x0pherl/fender-bender/(threads)

Thread 1 (2024-09-26):

Request for a "drybox" configuration

x0pherl, 2024-09-26:
Request on reddit announcement:

> I'd like an airtight, "drybox" version of this. It is rather humid in my house and I need a closed path to the printer.

There's already a "solid walls" option in the config, but this would also require a box around the bottom part.

x0pherl, 2024-11-11:
The external walls and bottom bracket now all feature a drybox configuration generated to the "alt" directory. This will be included in release 2.0

Closed 2024-11-11.

Thread 2 (2024-09-27):

Question: How doe this improve on your older design?

JohnOCFII, 2024-09-27:
I've been using your previous design successfully since 2021.  I'd love to hear how this differs.  I really like unit I'm using but have considered a change for three reasons:

1) Filament seems to break when sitting for more than a week.  This might be unavoidable due to the way the filament is positioned as it flows through the buffer.

2) Occasionally I struggle to get the filament to exit the unit as it gets caught on the M10, and I have to twist it quite a bit to get it to flow smoothly through the opening.

3) I'd like to try to better seal the box, as I've found that I get much better prints when my filament is dry, and while I'm starting from a sealed/dry RepBox, the current solution is out in the open.  I guess I can go with the sealed walls as a start.

Thanks!

x0pherl, 2024-09-27:
hey, nice to know the previous design was working for you. i'll address your issues and talk about general improvements.

1. that's a factor of the PTFE tubes, filament gets brittle in the tubes. i've seen this discussed enough to consider it "generally known" although google might reveal reasons. the "standard version" of this new design uses 3mm ID, 6mm OD tubing; I'm curious to see if this helps with that problem, but i haven't been using it long enough to know yet.
2. this design uses no connectors on the buffer, or alternative bottom brackets use "pass through connectors". In either of these cases, the path of the filament through the connector (and even through the part) is lined, which eliminates the catching you describe (and also greatly reduces overall friction. this was a design goal for this project
3. There's already an [issue ](https://github.com/x0pherl/fender-bender/issues/1) opened for a sealed version; this will mostly require some redesign of the bottom part but it should be pretty easy, but it will be a while before I get to it. But thanks for weighing in, I definitely am interested in what folks are looking for, and this seems to be a common request.

Other improvements:
- the path of the filament now exits the buffer at a 45 degree angle. installing such that there's a straight path to your filament and a straight path to the MMU has cut friction more that 4x from the design you're using (in fact my first model did that so effectively that it pushed the filament right around the wheel and back into my repbox)
- the "bracket" no longer has those awful printed screws, it just snaps into place. this makes me happy every time I assemble one.
- you could achieve this without printing a whole new buffer, but the PTFE stepdown adapter design makes the path from the buffer to the printer more easily user serviced. this makes loading filament way easier.
- the 6mm OD tubing is significantly more durable than 4mm tubing. it makes it a little "stiffer" when changing filament, but should mean better performance and durability over time.
- the new design is much easier to tinker with than the old one, which should allow for more variants in the future (such as a drybox config or different entry / exit angles, etc.
- there are 3 different "locking mechanisms" for the new design -- they simply "snap" into place with a click lock point, which has worked well enough for me without further locking. but there's also a per-bracket sliding pin (as before) or a pin that slides in from the side. if the click lock holds up over time then this will make changing filament easier.
- the top and bottom of the buffer now can mount to the wall, which will allow for 2 connection points on the same stud.

generally if you have something in place that's working for you, you may want to hang on for a bit and see what comes down the pike as folks raise issues or feature requests and I address them ¯\_(ツ)_/¯

I will say that if you have spare cycles on your printer and you're willing to burn through the filament to test this model, I would greatly appreciate your perspective as someone who used the previous version. However, I would still probably recommend that you wait for solid walls and a sealed bottom before testing. That's also likely to give me some time to address some other minor concerns. I'll be populating issues after Printopia weekend which should give you an idea of what's coming.

Closed 2024-10-03.

Thread 3 (2024-11-09):

a tabletop hanger for the bracket would be an improvement

x0pherl, 2024-11-09:
a hanger that can be installed on a flat surface would make maintenance easier on a wheeled table or cart

x0pherl, 2024-11-11:
added with https://github.com/x0pherl/fender-bender/commit/9057398a328450b43da6ef37627eab42d8e54e7a

Closed 2024-11-11.

Thread 5 (2024-11-09):

Build doesn't execute without vscode open

x0pherl, 2024-11-09:
show and export 2d require an open cad viewer. would be helpful to start with a test to determine if one exists and fail gracefully if it doesn't at a minimum (would be nicer if it opened a viewer)

x0pherl, 2024-11-09:
note -- terminal command as shown in vscode is
`"c:\Users\<user>\code\3d-print\fender-bender\.venv\Scripts\python.exe" "c:\Users\<user>\.vscode\extensions\bernhard-42.ocp-cad-viewer-2.6.1\ocp_vscode\backend.py" --port 3939`

x0pherl, 2024-11-11:
it now fails gracefully -- these notes may eventually lead to a clue to get it running on the runner machine:
# from ocp_vscode.standalone import Viewer
    # need to work out how to get ocp_vscode standalone running on the gitlab runner
    # cfg = {}
    # cfg["host"] = '127.0.0.1'
    # cfg["port"] = 3939
    # Viewer(cfg).start()

Closed 2024-11-11.

Thread 6 (2024-11-09):

need to publish other frame sizes for Enraged Rabbit

x0pherl, 2024-11-09:
a quick check found kits available for 8 and 12 filaments; might be worth checking in on discord or reddit

x0pherl, 2024-11-12:
4, 8, and 12 seem to be commonly available kit configurations. Adding 8 & 12 should be a good start (printing the standard 5 for a 4 config seems reasonable)

x0pherl, 2024-11-27:
added with v2

Closed 2024-11-27.

Thread 7 (2024-11-09):

need alternate filament paths to go with desktop mount option

x0pherl, 2024-11-09:
at a minimum, should add alternative models for:

- straight in, straight out
- "backwards" arrangement of straight out, 45 degrees in (although it would be used as straight in/ 45 out facing backwards

x0pherl, 2024-11-13:
added with https://github.com/x0pherl/fender-bender/commit/32b83d2b1f8a571d872fd19e0d82b48436b5e907 and ready for physical prototyping for inclusion with v2

Closed 2024-11-13.

Thread 9 (2024-12-29):

I cant find the reccomended fillament type in the documentation

KiwiHuman, 2024-12-29:
I cant find the recommended filament type in the documentation, What type of filament do you recommend for the printed parts? is PETG fine or should I print in ABS, either way the documentation should include this information.

x0pherl, 2024-12-29:
that's a fair point and I'll update the docs.

unless you plan on installing the buffer inside a heated chamber it shouldn't matter, although the properties of various materials may impact the lifespan of the click fit connectors. I've only tested with PLA and PETG and can't point to any significant practical differences

x0pherl, 2025-05-07:
apologies for the long delay but closing this out with a small doc update
