x0pherl/fender-bender/(commit log)

2024-06-03 functional bracket design more or less complete
2024-06-04 prototype response changes to increase the size of the connector diameter and set the wheel brace thickness properly, and then compensation for the fallout from that on the geometry
2024-06-04 lint cleanup of filament_bracket; add empty file for the top frame
2024-06-04 corrections to bracket depth and lateral wheel spacing after prototype testing
2024-06-04 flattened tube funnel profile along the wheel's axis
2024-06-05 a first attempt at a frame bracket and some related refactoring
2024-06-05 cleanup and improvements after printing the top frame
2024-06-08 clip bar position and orientation has been improved; added balls and sockets on the back-end hoping the printed prototype is close to final
2024-06-08 added the back clip zone to the frame side
2024-06-11 multi-part frame ready for protype printing; exterior walls thickened; some intial work towards extending the frame down for holdinng the cages
2024-06-21 added a break to the sweep cut for the back snap fit. did some related refactoring/cleanup
2024-06-21 addressed a small fillet issue on the top frame
2024-06-23 updated to export STL files
2024-07-04 front and back wall cuts positioned in top frame
2024-07-08 click fits in place for all walls; prototypes printing
2024-07-10 all parts but bottom bracket ready for testing
2024-07-11 connector bracket added
2024-07-11 refactoring to allow for debug view independently from frames; thickening of back wall in prep for wall hangers
2024-07-12 fixed bugs in the debug assembly view
2024-07-12 wall bracket added and ready for prototype print
2024-07-13 addressed wall bracket geometry issues
2024-07-14 deeper screwhead inset
2024-07-15 adjusted to add more flat surface to the channel box for printing; will require physical testing
2024-07-15 added a click to fit connector along the sides -- currently prototyping a physical print, may need to undo this idea
2024-07-15 front and back walls / grooves now have clips ; side click brackets rolled back
2024-07-16 bug fixes on tongue alignment for the guide rail sides
2024-07-16 Updated snap fit connector to a center ball & socket. physical prototype works well
2024-07-17 bug fix on the x position of the top cut
2024-07-27 new filament egress path design. the egress tube needs to be positioned higher in the bracket, and some cleaning warnings need to be looked into
2024-07-27 added threads to curved filament channel and the filament bracket
2024-07-30 prototype ready version of a rounded frame
2024-08-04 new frame shape off for initial prototype print
2024-08-04 all parts of the new design are fully ready for prototype printing, needs cleanup
2024-08-05 updated the pin cut in the filament bracket to make insertion easier
2024-08-05 fixed connector bracket cut block positioning
2024-08-05 added a frame bracket clip part
2024-08-09 frame clip now in place on bracket and frame, ready for prototyping
2024-08-09 added bottom frame stand as option for installations that aren't hanging from a wall
2024-08-09 updated stl export file names for more consistency and clarity
2024-08-09 added a grip to the filament bracket clip
2024-08-09 added tolerance to the bracket clip and fixed other issues discovered in prototyping the clip, including re-working the way the top bracket is defined
2024-08-09 cleaned up linting issues in filament_bracket.py and tested all other exporting files
2024-08-09 cleaned up linting issues in frames.py and tested all other exporting files
2024-08-10 cleaned up linting issues in filament_wheel.py and walls.py and tested all other exporting files
2024-08-10 flipped the orientation of the bottom frame when adding the stand for easier printing
2024-08-10 addressed spacing issues with the top frame bracket and the connector bracket
2024-08-10 adjustements to the clip cut positioning in the frame based on physical prototype results
2024-08-11 fine tuning the connector cut alignment
2024-08-11 fixed debug view for bottom bracket when not set up for wall hanger
2024-08-12 post prototyping tweaks to the frame clip design & placement
2024-08-13 bracket clip refactoring
2024-08-13 refactored cutblock and eliminated tolerance on the bracket/frame fit to better align the clip
2024-08-13 added a rail to the top of the bracket clip
2024-08-13 updated the rail width of the clip
2024-08-13 added to the overall length of the frame to account for increased wall size
2024-08-23 updates to the bracket clips after protype testing: clips are now un-angled, and have click lock points
2024-08-26 refactoring of the bracket clip
2024-08-26 frame updated to use new rail block
2024-08-28 fixed thicknes of reinforced sidewalls to match frame & guide walls
2024-08-28 moved frame half view to debug_view_assembly & fixed __main__ call
2024-08-28 removed second guide wall (mirroring can be acheived by flipping one upside down when assembling!)
2024-08-28 frame rail position corrected; moved test to debug_view_assembly
2024-08-28 added a lock rail to pin the filament bracket, and made the lock style configurable
2024-08-28 increasing the tolerances for the lock rail after prototyping
2024-08-28 after physical testing, added a slight increase on the length of the output of the curved filament line to make it easier to bend the tube through the connector
2024-08-28 created separate tolerance for the lock pin based on testing (and renamed "lock rail" to lock pin for clarity)
2024-08-31 added a hole to the bracket clip handle to make it easier to pull out
2024-08-31 correction in locking pin frame alignment
2024-08-31 increased the size of the lockpin tie hole on the top frame
2024-08-31 tolerance adjustements to the wall hanger cut template
2024-08-31 added a hybrid mode for the frame to have both the wall hanging component for the top frame and the stand added to the bottom frame
2024-09-01 updated sidewall_section_depth to be a calculated value based on the deisred overall "frame_chamber_depth" (new config variable added) -- which is a more realistic value for someone identify when des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
2024-09-01 adjusted tongue & groove spacing on the front and back connections to ensure that the click points happen at the midpoint beteween the sidewalls for easier assembly
2024-09-02 updated the click sphere to account for the frame hanger offset, added a useful debugging view in cut_frame_test() for troubleshooting frame/bracket alignment issues
2024-09-02 shrunk the wall bracket for a cleaner exterior look
2024-09-03 adjusted length of guide sides to allow better fit of the walls into the frames
2024-09-04 getting rid of the frame hanger for the minimal test set to speed up print times
2024-09-04 updated frame_chamber_depth after testing prototype
2024-09-05 added support for a minimal bracket depth, so that you can share a common frame even if working with parameters that would result in a shallower bracket
2024-09-05 now that the prototype's looking pretty good, I needed a good way to physically test the printed prototypes -- the torture-test.gcode basically just loads and retracts each filament resuling in 40 lo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
2024-09-06 changes for testing in the prototype config
2024-09-06 updated filament channels to a partomatic so it's properly reading from the configuration file instead of defaults
2024-09-06 added a connector_threaded value to each config file to get the build to work
2024-09-06 refactored frame elements out of basic_shapes
2024-09-06 fix to lock pin generations
2024-09-06 testing changes to hex pattern on walls to reduce filament & increase visibility
2024-09-07 reducing sidewall_width for more effective overall fit & material reduction
2024-09-07 changes to the test configs and the way rotating the bottom bracket in debug view is handing
2024-09-07 Correcting an inconsistency in STL file naming
2024-09-07 fixed display rotation for bottom frame in debug view
2024-09-07 reverting changes to wall width; caused issues with fitting the bracket
2024-09-07 restoring previous chamber cut length; need to look into better ways of improving the insertion alignment
2024-09-07 increased the length of the pin channel and guide
2024-09-07 updated bank_config to add minimum bracket height & width
2024-09-08 undid longer guide pins after prototype testing
2024-09-09 updated the shape of the chamber cut to better guide the bracket into place, prototyping was successful
2024-09-09 the filamenet clip offset was not adjusting for the inner cylinder, resulting in a snug fit
2024-09-09 adjustements to tolerance of lock pin after prototyping
2024-09-10 adjustments to the lock pin alignment
2024-09-10 adjustments to frame pin and clip based on physical testing
2024-09-15 bug exposed by the behomoth configuration in the bottom frame stand
2024-09-15 fixed issues in placement of the hole on the handle of the bracket clip
2024-09-17 added a channel for a screw along the bottom bracket. note: the bottom bracket method is getting a little unwieldy -- accepting the technical debt to get the prototype tested before demoing at the co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
2024-09-19 post prototyping adjustments to the bottom frame screw bracket
2024-09-22 changed config files from .INI files to YAML to allow for nested or arrayed values in future updates, including (1) work to support configuration that allows for multiple connector or frame style par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
2024-09-23 created new dataclasses for tube configuration and connector configuration and updated the bankconfig to include a list of connector configurations.
    for now only the first connector is considered, but the goal is to eventually handle all connector configurations within the config. (connectors is a list within the config)
2024-09-23 moved the wheel and bearing configurations into nested data classes.
2024-09-25 this commit adds support for building multiple filament bracket bottom parts for multiple connector configurations in the build configuration.
2024-09-25 this commit adds a utility function generate_funnel_test_parts to debug_view_assembly which generates partial filament bracket STLs for testing tube and connector configuration changes
2024-09-25 pushing FilamentWheel earlier in the build process to generate those parts faster for prototyping
2024-09-25 Eliminated "FrameStyle" as a configuration variable; now each config generates a hybrid frame as well as alternative parts for standing or hanging frames as appropriate for each part
2024-09-25 addressed bug with screw tab for wall mounting
2024-09-25 tube sizing adjustment
2024-09-25 updated walls to handle rendering 2d views for assembly instructions on build
2024-09-26 added image generation for the filament bracket
2024-09-26 Framework in place for documentation
2024-09-27 updated logo to add support for a simplified logo for use in smaller printed parts
2024-10-08 working to make components more idempotent. Filament Wheel now can load and manage it's own configuration independent of the overall bender configuration. it also can load a single node within a yaml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
2024-10-08 general code review of filament wheel changes: removed some duplicated code from filament_wheel and moved the FilamentWheel and BearingConfig types to their own file
2024-10-08 addressing testing issues; updating "move" to "moved" in filament bracket display and 2d
2024-10-10 finally getting some unit tests in place; filament wheel coverage > 97%
2024-10-15 filament bracket tests added
2024-10-15 frames test added
2024-10-21 filament bracket & channels tests added
2024-10-21 increased filament wheel coverage, and bugfix: updated __init__ in FilamentWheel to properly load a WheelConfig object
2024-10-21 added tests for lock pin and the wall hanger cut template
2024-10-22 basic frames tests added
2024-10-28 This is a fairly large commit that decomposes walls into 3 elements -- sidwall.py, guidewall.py and assembly_documentation.py
    this was done to make this easier to read and maintain, and to work towards a strategy where each element has it's own config that contains exactly the information required to build that element.
    necesarry changes to other objects are indluded as well.
2024-10-31 increasing lock pin tolerance for various configurations
2024-10-31 fixed default STL folder in WheelConfig and related tests
2024-10-31 one more stl folder fix
2024-11-03 okay, this is an unfortunately large commit, but frames was a massive monolith that's been decomposed into more manageable chunks; documentation & part generation files have been updated, and tests a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
2024-11-03 updated bottom bracket export to include the tybrid part as well as to position the part properly for printing
2024-11-03 the filament wheel stl was not being generated in the right location; rather than implement a complex solution to the clashing hierarchical dataclasses, I've removed the stl_folder from the wheelconf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
2024-11-07 added a print-in-place option for the filament wheel
2024-11-07 update to stop creation of an stl file on basic execution of bearing.py
2024-11-09 re-factoring to unify the TopFrameConfig/BottomFrameConfig and ConnectorFrameConfig into a single data type
2024-11-10 added drybox config to the bottom frame
2024-11-11 added a desktop bracket and restored the wall bracket in the brackets.py file. needs physical prototyping
2024-11-11 fixed output directory for alt/wall-side-reinforced-solid.stl
2024-11-11 fixes to m4_nut_radius sizing and the desk bracket after physical prototyping
2024-11-12 eliminated the 2d_render from FilamentBracket's __main__
2024-11-12 support for straight path and reverse path filament brackets
2024-11-13 updates to allow alternate filament count overrides through build.py
2024-11-13 shrinking the filament wheel size from the minimal test set so it prints smaller
2024-11-13 The name "brackets" was ambiguous and could be confused the "filament bracket" component. Renamed to Hanging Bracket
2024-11-13 change to the geometry of the TopFrame to support reverse path filament brackets
2024-11-14 updating the sidewall geometry to address frame fit
2024-11-14 adding tolerance to the guide rails to allow for a snugger fit of the tongue/groove connection. reverting debug_view assembly to display complete assembly
2024-11-15 turns out filament_bracket didn't get swept up in the big refactoring clean-up. this is a much cleaner implementation of note: this is a WIP commit as the build script no longer builds a complete set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
2024-11-17 this W.I.P. commit has the planned changes to partomatic and tests that show how the generic partomatic_config interface can be used to reduce code reuse in other config & partomatic objects all test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
2024-11-20 okay, this is a big terrifyingly massive refactoring commit, but the resulting code is much more maintainable. all parts are now refactored to work with the new partomatic design, and all test are pa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
2024-11-21 adjustements to minimal test set -- shrinking the overall length to match the smaller wheel size
2024-11-21 removing the partomatic message at stl generation
2024-11-21 addressing difference in the click fit distance between the guidewall and the frame -- there's now a "click_fit_distance" property to control it
2024-11-21 updates to properly align the lock pin
2024-11-23 adjustment to the wide cut to allow for proper fitting of the filament bracket
2024-11-24 bender_config.filament_count was being updated within some sets; which was resulting in default parts having 12 chambers
2024-11-25 updates the bottom location and orientation based on frame_style; for easier printing
2024-11-26 updates to ensure that the distance between the surface mount bolts is always a multple of 10mm
2024-11-27 updated FrameStyle docstring
2024-11-27 Fixes and refactoring regarding frame generation in the build script
2024-11-27 updates to offset the screw positioning for even filament count brackets
2024-11-28 adds support for a printed twist-snap connector to simplify connecting and disconnecting tubing when loading
2024-12-03 updated shape of filament tube insets with peaks to account for FDM bridging deformation
2025-05-07 Updated to share material recommendations per https://github.com/x0pherl/fender-bender/issues/9
